scotthew1/autocar/docs/img/logicFlow.png

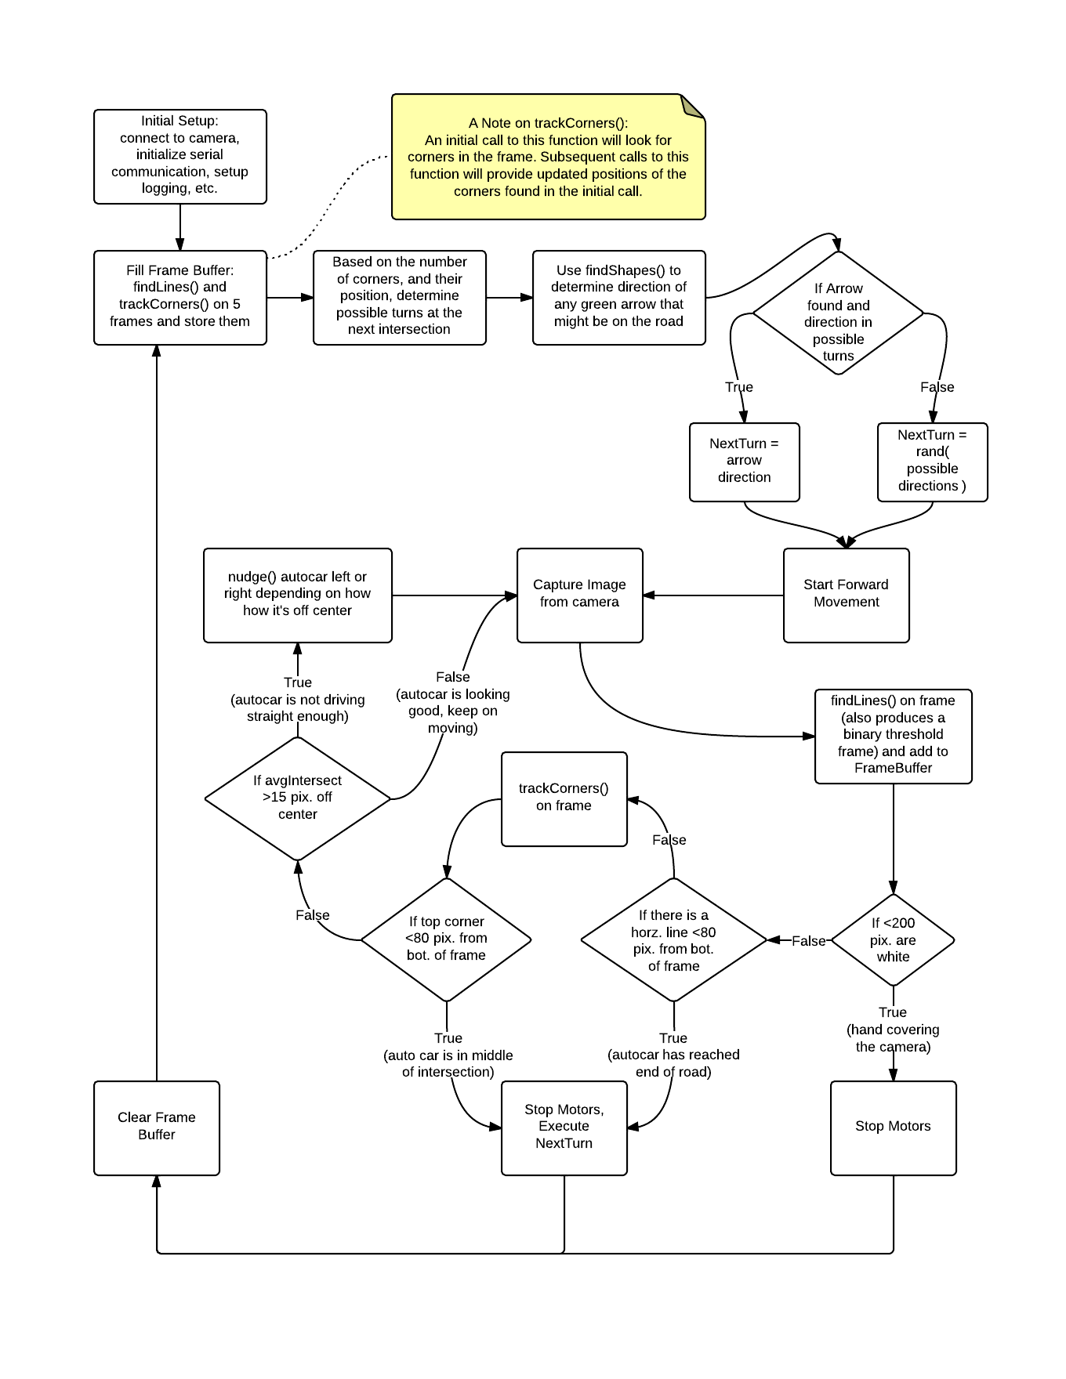
docs/img/logicFlow.png
