scotthew1/autocar/docs/img/mongooseCity.png

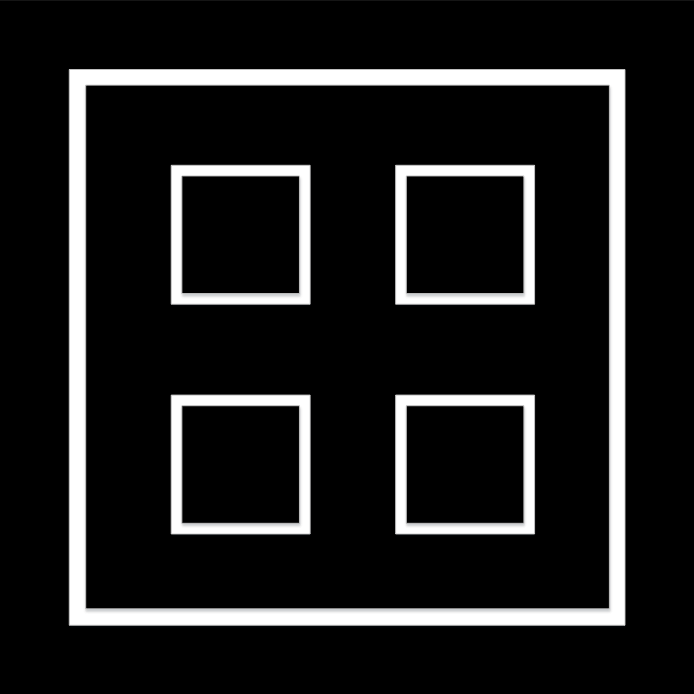
docs/img/mongooseCity.png
