scotthew1/autocar/(commit log)

2014-02-26 Motor Driving and Motor Turning are not working together. SLEW is set for turning. Then the mode needs to be changed for the robot to drive(which is possible). Then it needs to change back to SLEW wh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
    [autocar_slave.ino]
2014-03-04 fixed a dumb error in findShapes, added my setup script
    [findShapes.py]
2014-03-06 Updated turning and loop functions to use RESET. Needs testing.
    [autocar_slave.ino]
2014-03-06 Turning and Driving are now working together properly with the use of FLOAT, RESET and SLEW in the correct place.
    [autocar_slave.ino]
2014-03-18 Added EOPD function. Added Reverse function. Edited Increment and Decrement functions to take a parameter to change the power by different values. Commented code.
    [autocar_slave.ino]
2014-03-19 UART communication code
2014-03-19 Command library for BeagleBone to Arduino.
2014-03-19 Command library for BeagleBone to Arduino
2014-03-19 UART Arduino Code Update
2014-03-19 Updated commandLib fixed errors
    [commandLib.py]
2014-03-20 Added readBeagle function. Shortened a few delays in the turning functions. Re-testing turning function and all works.
    [autocar_slave.ino]
2014-03-20 Wrote in motor function into the case statements in readBeagle function.
2014-03-23 fixed/cleaned up arduino code
    [autocar_slave.ino]
2014-03-23 tryna fix communication on the arduino
    [autocar_slave.ino, commandLib.py]
2014-03-23 more arduino to test
2014-03-24 will UART finally work???
2014-03-24 Working Ardunio Code/ Communication on the Uno. Next step testing communication with motor function.
2014-03-30 Added nudge function for directional correctness.
    [autocar_slave.ino]
2014-04-01 took out Serial prints that I left in the code
2014-04-01 Tweaked nudge function for more percise correction
    [autocar_slave.ino]
2014-04-03 Added LED.py to test the LEDs. Started to write the communication code but am unaware of what to send over the line.
2014-04-04 Working ledLib.py
2014-04-04 Update check function in Arduino. Updated LED.py for show all possible combinations.
2014-04-04 LED fix
2014-04-04 Update to LED library
2014-04-04 New file name for LEd library
2014-04-04 ledLib cleanup
2014-04-05 Error in Arduino code...All fixed.
    [autocar_slave.ino]
2014-04-05 fixed bug in nudge
    [commandLib.py]
2014-04-06 added support to check battery status
2014-04-06 fixed bug in findShapes, early support for horizontal lines in findLines
    [videoLib.py]
2014-04-08 Added the framework for the various sign detection.
2014-04-09 fixed some more logging issues, survived a meltdown
    [commandLib.py, main.py, videoLib.py]
2014-04-09 added a cleanup function to VideoCapture that will hopefully prevent startup errors
    [main.py, videoLib.py]
2014-04-09 fixed bug in main
    [main.py]
2014-04-10 Updated ledLib and Autocar_slave
2014-04-10 added to setup.sh to keep video values fixed, some changes to adjuest for it
    [main.py, videoLib.py]
2014-04-10 set max framerate to 15, fixed bugs in findShapes
    [videoLib.py]
2014-04-10 changes to nudge and track corners for the new camera
2014-04-11 still tryna get the new camera to play nice
2014-04-11 implemented reset by blocking camera
    [main.py, videoLib.py]
